zaoshui2005/AC-AC-Converter/Images/hardware/system_hardware_block.png

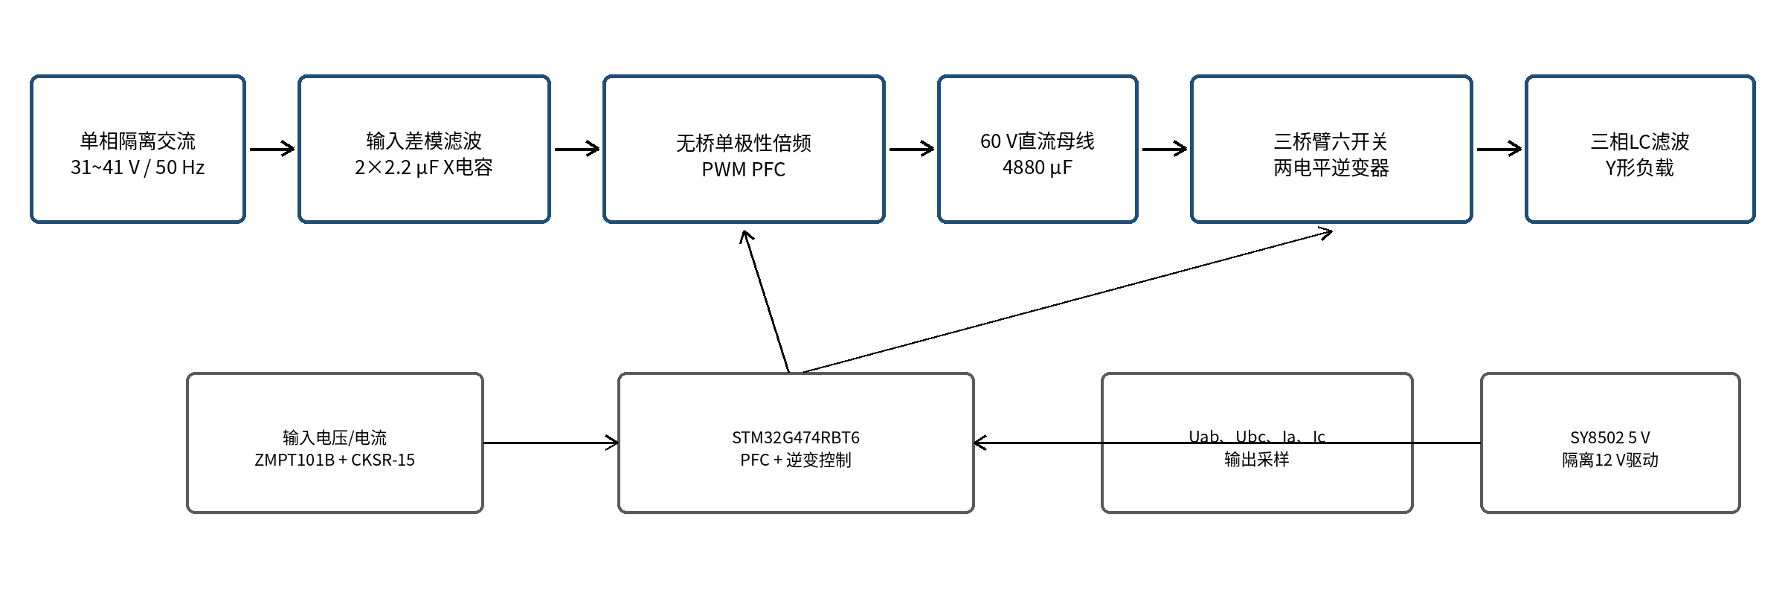
Images/hardware/system_hardware_block.png
