zaoshui2005/AC-AC-Converter/threenibian.ioc

Mcu.UserName=STM32G474RETx
PA0.Signal=SharedAnalog_PA0
PA1.Signal=ADC1_IN2
PA10.Signal=HRTIM1_CHB1
PA11.Signal=HRTIM1_CHB2
PA3.Signal=ADC1_IN4
PA4.GPIO_Label=KEY_FREQ_DOWN
PA4.Signal=GPIO_Input
PA6.Signal=ADC2_IN3
PA7.Signal=ADC2_IN4
PA8.Signal=HRTIM1_CHA1
PA9.Signal=HRTIM1_CHA2
PB0.Signal=SharedAnalog_PB0
PB12.Signal=HRTIM1_CHC1
PB13.Signal=HRTIM1_CHC2
PB14.Signal=HRTIM1_CHD1
PB15.Signal=HRTIM1_CHD2
PB5.GPIO_Label=KEY_FREQ_UP
PB5.Signal=GPIO_Input
PC0.Signal=ADC1_IN6
PC1.Signal=ADC1_IN7
PC14-OSC32_IN.Signal=RCC_OSC32_IN
PC15-OSC32_OUT.Signal=RCC_OSC32_OUT
PC2.Signal=ADC1_IN8
PC6.Signal=HRTIM1_CHF1
PC7.Signal=HRTIM1_CHF2
PC8.Signal=HRTIM1_CHE1
PC9.Signal=HRTIM1_CHE2
PF0-OSC_IN.Signal=RCC_OSC_IN
PF1-OSC_OUT.Signal=RCC_OSC_OUT
