zaoshui2005/AC-AC-Converter/Core/Inc/main.h

#define KEY_FREQ_DOWN_Pin GPIO_PIN_4
#define KEY_FREQ_DOWN_GPIO_Port GPIOA
#define KEY_FREQ_UP_Pin GPIO_PIN_5
#define KEY_FREQ_UP_GPIO_Port GPIOB
