zaoshui2005/AC-AC-Converter/Images/hardware/整体.jpg

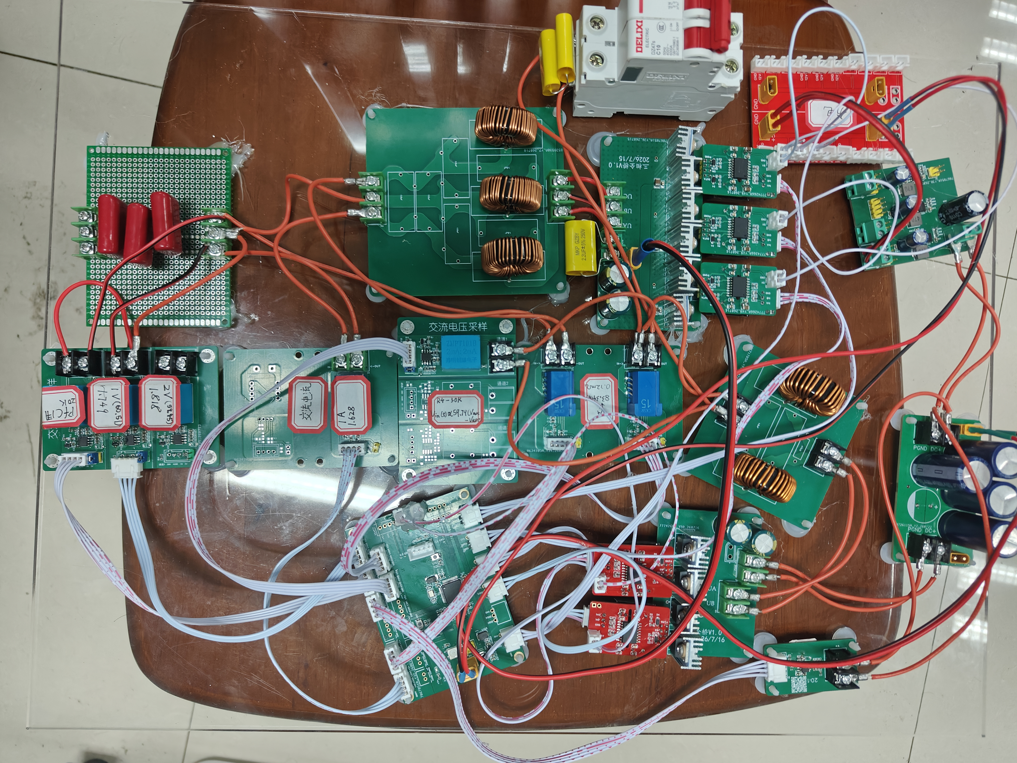
Images/hardware/整体.jpg
